Harmvdw/mechanisch-toetsenbord/docs/bronnen.md

# Bronnen

Opgehaald op 10 november 2026. Bron 2 t/m 5 komen uit samenvattingen van de opgehaalde pagina's, niet uit de originele bestanden. Bron 1 en 6 zijn direct in de browser gelezen.

| # | Bron | Status |
|---|---|---|
| 1 | https://github.com/vipul-sharma20/keebs/tree/main | Via de browser gelezen: structuur en kleine delen van de inhoud. Verwerkt in 07. De tool-ophaling werd eerst geweigerd (robots.txt). |
| 2 | https://vipul.xyz/2024/10/lily58-keyboard/ | Opgehaald. Verwerkt in 02, 03, 05. |
| 3 | https://github.com/qmk/qmk_firmware/blob/master/keyboards/lily58/readme.md | Opgehaald (samenvatting). Verwerkt in 01 en 04. |
| 4 | https://github.com/kata0510/Lily58/blob/master/Pro/Doc/buildguide_en.md | Opgehaald (samenvatting). Verwerkt in 02, 03, 05. |
| 5 | https://github.com/kata0510/Lily58 | Opgehaald: alleen mappenstructuur en README. Inhoud van de submappen niet bekeken. Verwerkt in 01. |
| 6 | https://www.printables.com/model/1321348-handwired-lily58 | Via de browser gelezen: beschrijving, onderdelenlijst, bedrading, firmware, licentie. Verwerkt in 08. Tabblad Files niet bekeken. |

## Wat er mist

- Bron 1: `rules.mk` en `keymap.c`, de andere keymaps, licentie van de repo. De STL- en Gerber-bestanden zijn wel gemeten (zie 09).
- Bron 6: tabblad Files, opmerkingen, bedradingsvideo.
- Bestanden in de submappen van bron 5 (`Pro/PCB`, `case`, `pcb`, `Pro_V2`, `Lite_Rev3`).
- De QMK-bestanden naast de readme (`info.json`, `config.h`, `rules.mk`, keymaps).

## Licentie

Aan de repo van kata0510 hangt een `LICENSE`-bestand. Het type is niet gecontroleerd. Neem geen PCB- of casebestanden over zonder de licentie te lezen.
