Harmvdw/mechanisch-toetsenbord/docs/05-lessen-en-problemen.md

# Lessen, fouten en tips

## Uit de Pro-gids (kata0510)

Tips
- Markeer voor- en achterkant van elke print met maskeertape.
- Open de dioden-verpakking langzaam en werk boven een schoteltje: de onderdelen vliegen weg.
- Voorsolderen om onderdelen vast te zetten.
- Defecte switch: verwijderen, pinnen op kromming controleren, opnieuw plaatsen.

Waarschuwingen
- Zwarte versie: krasvaste coating (soldeermasker), maar krassen door transport zijn mogelijk. Na montage krast de case snel.
- Verkeerd geplaatste diode: de toets reageert niet.
- De Pro Micro-socket is kwetsbaar. Magnetische micro-USB-connector aanbevolen.
- Kailh Box- en Choc-switches vragen kracht bij het plaatsen.
- Sockets niet met de hand vasthouden tijdens het solderen.

Storingen
- Rij of kolom reageert niet: Pro Micro niet goed gesoldeerd. Opnieuw solderen en monteren.
- Eén toets reageert niet: switchmontage, socket en diode-soldeerverbinding controleren, diode-oriëntatie corrigeren.

## Uit de blog (vipul.xyz)

| Probleem | Oplossing of les |
|---|---|
| Diodes verkeerd geplaatst | Omkeren, opnieuw solderen |
| Losse verbindingen bij diodes en sockets | Opnieuw solderen |
| Pin headers Pro Micro maakten geen contact | Elke pin afzonderlijk nasolderen |
| Hardnekkige toetsen | Socket, diode en switch vervangen (loste 1–2 toetsen op) |
| Print beschadigd bij het verwijderen van pin headers (koperbanen los) | Uitwijken naar een ander bord |
| Beide helften als rechterhelft gesoldeerd | Alles ontsolderen. Helften zijn spiegelbeeldig. |
| Na eerste flash werkten ca. 10 toetsen niet | Soldeerfouten zoeken en herstellen |

Tips van de auteur
- Flash de firmware vóór de keycaps.
- Gebruik een multimeter om fouten te zoeken.
- Controleer of pin headers helemaal door de print gaan vóór het solderen.
- Plan bouw en logistiek goed (onderdelen uit het buitenland: douane en ontbrekende delen).
- Groen soldeermasker is goedkoper dan zwart.
