Harmvdw/mechanisch-toetsenbord/behuizing/afbeeldingen/fusion_helft_rechts.png

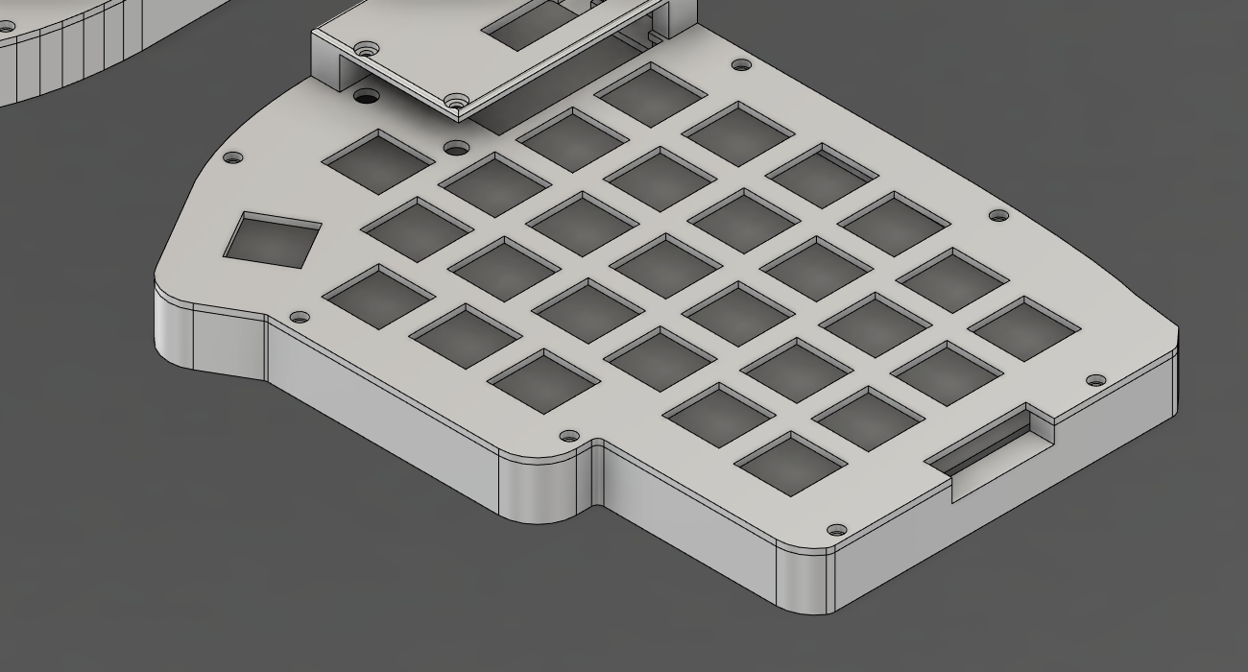
behuizing/afbeeldingen/fusion_helft_rechts.png
