Harmvdw/mechanisch-toetsenbord/behuizing/afbeeldingen/helft_3d.png

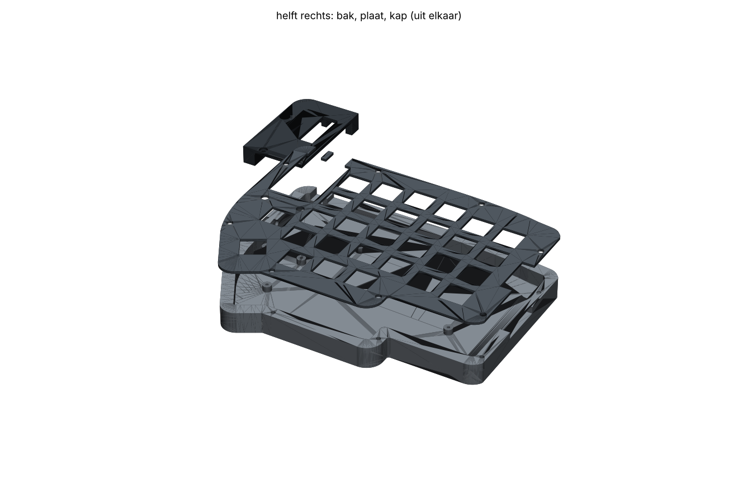
behuizing/afbeeldingen/helft_3d.png
