Harmvdw/mechanisch-toetsenbord/behuizing/afbeeldingen/helft_3d_gemonteerd.png

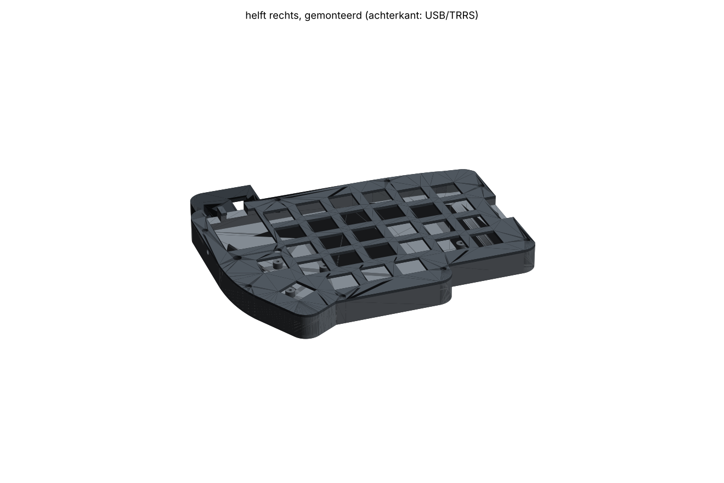
behuizing/afbeeldingen/helft_3d_gemonteerd.png
