Harmvdw/mechanisch-toetsenbord/behuizing/afbeeldingen/helft_doorsnede.png

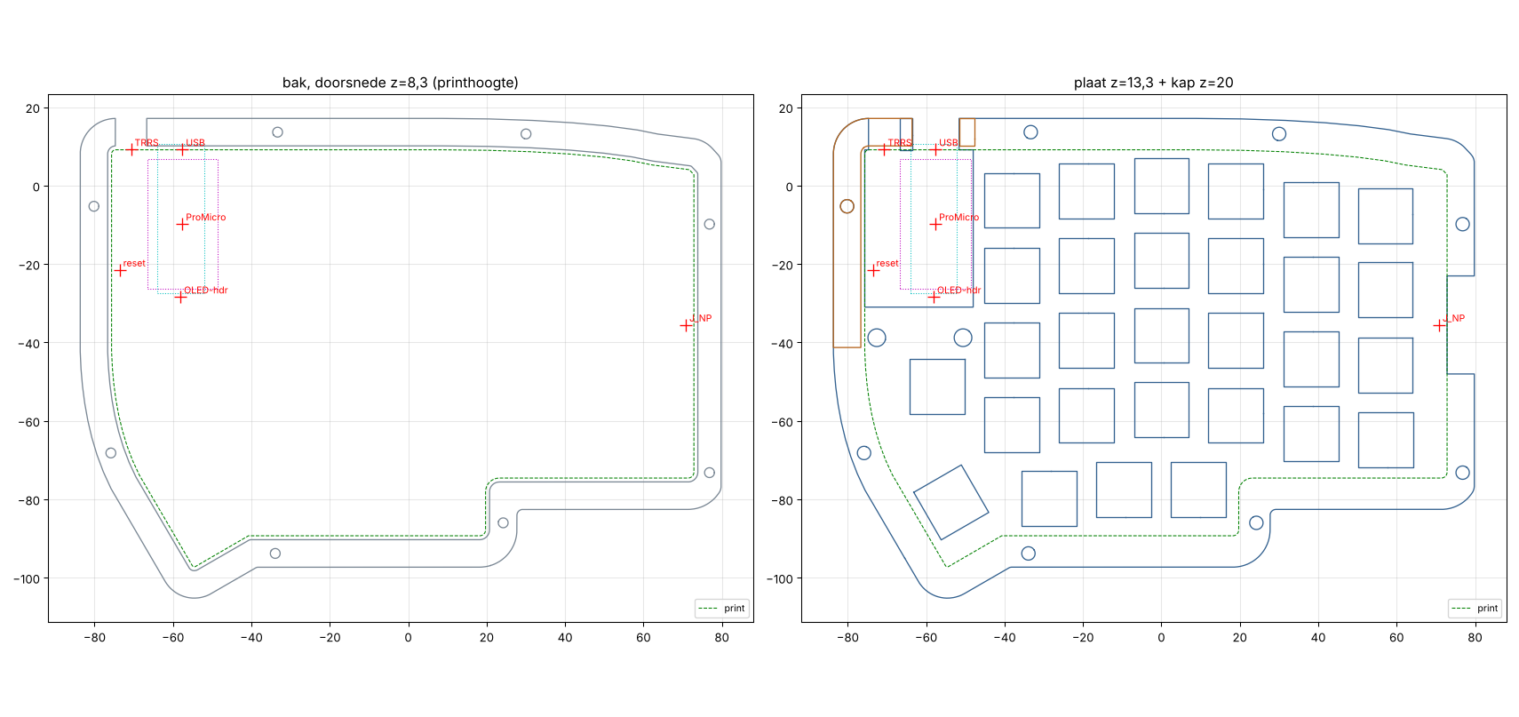
behuizing/afbeeldingen/helft_doorsnede.png
