Harmvdw/mechanisch-toetsenbord/behuizing/afbeeldingen/numpad_3d.png

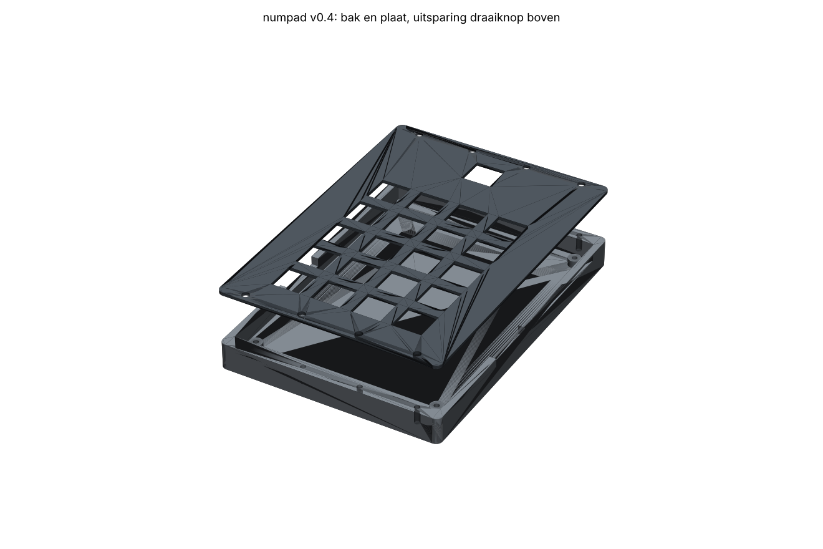
behuizing/afbeeldingen/numpad_3d.png
