Harmvdw/mechanisch-toetsenbord/behuizing/afbeeldingen/numpad_doorsnede.png

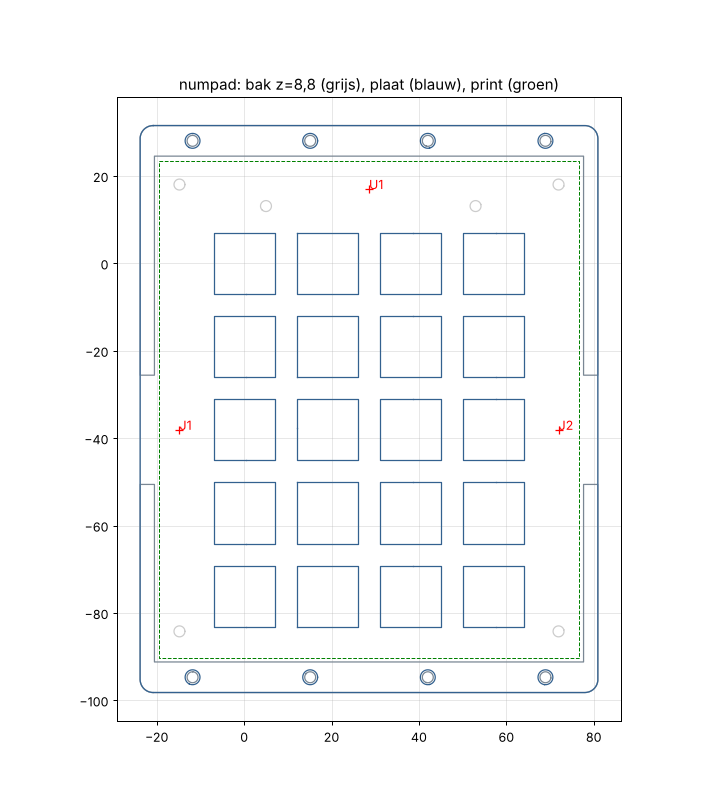
behuizing/afbeeldingen/numpad_doorsnede.png
