Harmvdw/mechanisch-toetsenbord/behuizing/export/numpad_bak.step

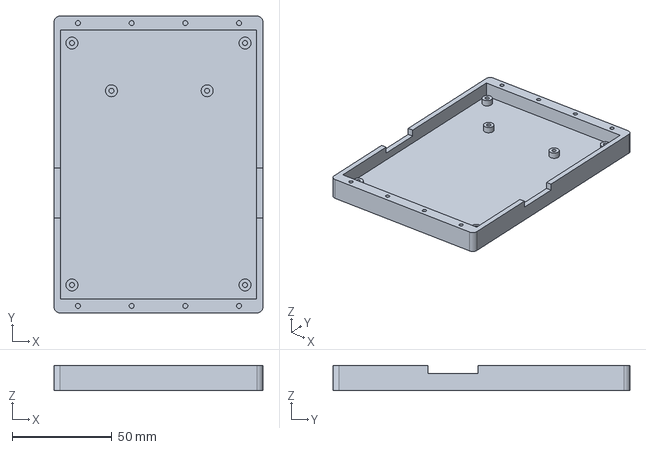
[picture p9: CAD file, 2026-11-13]
behuizing/export/numpad_bak.step
104.8 x 148.8 x 12.6 mm
