Harmvdw/mechanisch-toetsenbord/behuizing/export/numpad_plaat.step

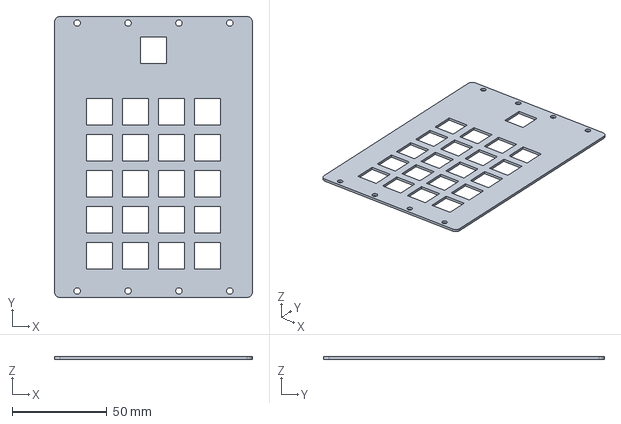
[picture p10: CAD file, 2026-11-13]
behuizing/export/numpad_plaat.step
104.8 x 148.8 x 1.50 mm
