Harmvdw/mechanisch-toetsenbord/behuizing/export/helft_rechts_kap.step

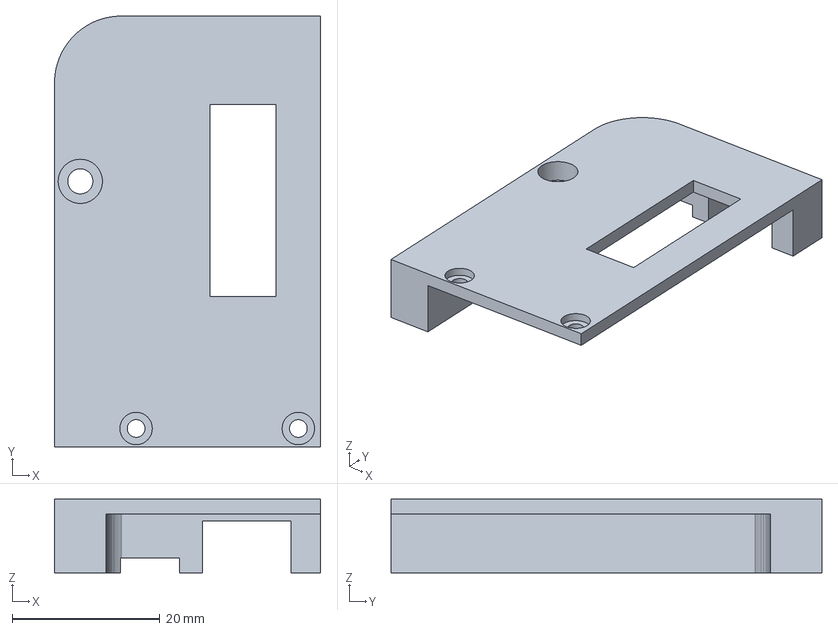
[picture p11: CAD file, 2026-11-12]
behuizing/export/helft_rechts_kap.step
36.1 x 58.4 x 10.0 mm
