Harmvdw/mechanisch-toetsenbord/behuizing/export/helft_rechts_bak.step

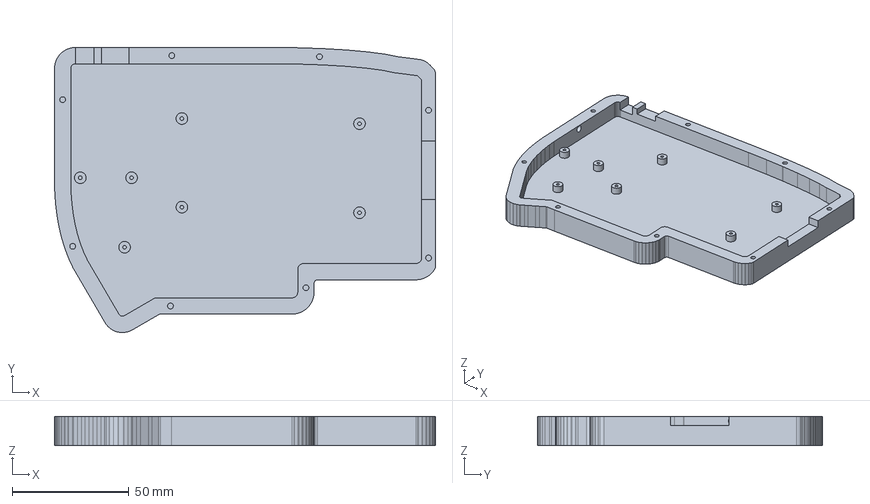
[picture p12: CAD file, 2026-11-12]
behuizing/export/helft_rechts_bak.step
163.5 x 122.3 x 12.6 mm
