Harmvdw/mechanisch-toetsenbord/behuizing/export/helft_rechts_plaat.step

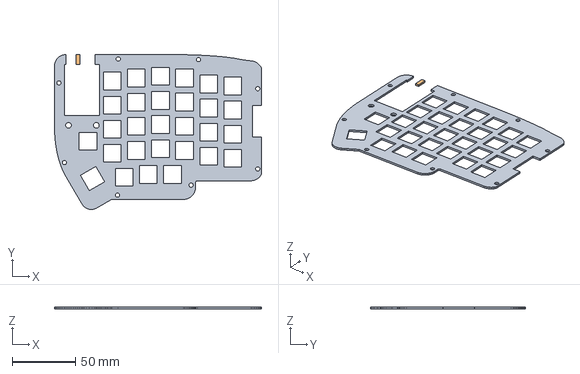
[picture p13: CAD file, 2026-11-12]
behuizing/export/helft_rechts_plaat.step
163.5 x 122.3 x 1.50 mm
