Harmvdw/mechanisch-toetsenbord/(list of files, cad)

Other CAD files:
behuizing/export/helft_rechts_bak.stl
behuizing/export/helft_rechts_kap.stl
behuizing/export/helft_rechts_plaat.stl
behuizing/export/numpad_bak.stl
behuizing/export/numpad_plaat.stl
