Harmvdw/mechanisch-toetsenbord/pcb/numpad/numpad.kicad_pcb

## KiCad design pcb/numpad/numpad.kicad_pcb (2026-11-13)

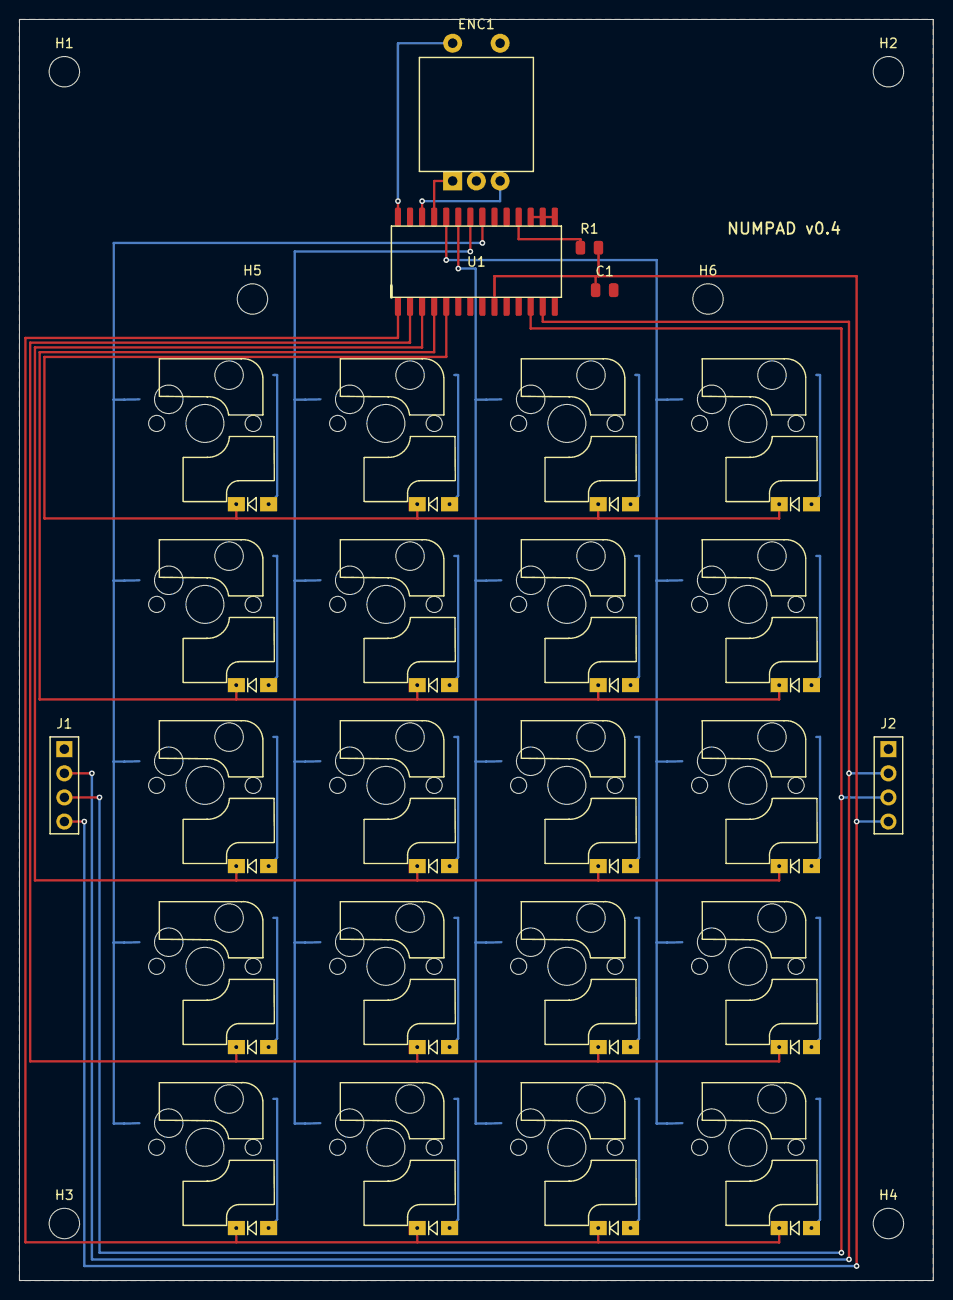
[picture p14: board numpad.kicad_pcb from above]

Board: 2 copper layers, 96.2 x 132.8 mm, 52 parts (0 on the bottom side), 37 nets.

Parts:
C1: 100nF; C_0805
D1, D2, D3, D4, D5, D6, D7, D8, D9, D10, D11, D12, D13, D14, D15, D16, D17, D18, D19, D20: 1N4148W; Diode_SOD123
ENC1: EC11 met drukknop; RotaryEncoder_EC11E_Switch
H1, H2, H3, H4, H5, H6: M3; MountingHole_3.2mm
J1, J2: Adafruit 5358; Magnetic_5358_1x4_P2.54_Vertical
R1: 10k; R_0805
SW1, SW2, SW3, SW4, SW5, SW6, SW7, SW8, SW9, SW10, SW11, SW12, SW13, SW14, SW15, SW16, SW17, SW18, SW19, SW20: MX_hotswap; CherryMX_KailhLowProfile_Hotswap_edge
U1: MCP23017-E/SO; SOIC-28W_7.5x17.9mm_P1.27mm

Connections:
GND: C1.2, ENC1.C, ENC1.S2, J1.1, J2.1, U1.10, U1.15, U1.16, U1.17
unnamed: D1.2, SW1.2
unnamed: D2.2, SW2.2
unnamed: D3.2, SW3.2
unnamed: D4.2, SW4.2
unnamed: D5.2, SW5.2
unnamed: D6.2, SW6.2
unnamed: D7.2, SW7.2
unnamed: D8.2, SW8.2
unnamed: D9.2, SW9.2
unnamed: D10.2, SW10.2
unnamed: D11.2, SW11.2
unnamed: D12.2, SW12.2
unnamed: D13.2, SW13.2
unnamed: D14.2, SW14.2
unnamed: D15.2, SW15.2
unnamed: D16.2, SW16.2
unnamed: D17.2, SW17.2
unnamed: D18.2, SW18.2
unnamed: D19.2, SW19.2
unnamed: D20.2, SW20.2
SCL: J1.3, J2.3, U1.12
SDA: J1.2, J2.2, U1.13
VCC: C1.1, J1.4, J2.4, R1.2, U1.9
nRESET: R1.1, U1.18
np_col0: SW1.1, SW5.1, SW9.1, SW13.1, SW17.1, U1.21
np_col1: SW2.1, SW6.1, SW10.1, SW14.1, SW18.1, U1.22
np_col2: SW3.1, SW7.1, SW11.1, SW15.1, SW19.1, U1.23
np_col3: SW4.1, SW8.1, SW12.1, SW16.1, SW20.1, U1.24
np_encA: ENC1.A, U1.25
np_encB: ENC1.B, U1.26
np_encS: ENC1.S1, U1.28
np_row0: D1.1, D2.1, D3.1, D4.1, U1.5
np_row1: D5.1, D6.1, D7.1, D8.1, U1.4
np_row2: D9.1, D10.1, D11.1, D12.1, U1.3
np_row3: D13.1, D14.1, D15.1, D16.1, U1.2
np_row4: D17.1, D18.1, D19.1, D20.1, U1.1
