Harmvdw/mechanisch-toetsenbord/(commit log)

2026-11-10 Voeg keebs-repo en Printables-model toe, werk bronnenlijst bij
    Claude-Session: https://claude.ai/code/session_01JpGuJ3zyjAJrwZ9p57ohZi
2026-11-10 Voeg gemeten maten uit STL's en Gerber-bestanden toe
    Toetsposities (CSV), stagger, printrand, plaat- en casematen en de
    meetscripts. Werk bronnenlijst en 06/07 bij.
    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
    [lily58-pro-switchposities.csv]
2026-11-10 Voeg Fusion-opzet toe en werk hoekmeting van duimtoetsen bij
    De toets op (105,0; -127,0) is 30 graden gedraaid, de rest recht.
    Beschrijf schetsen en parameters in docs/10.
    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
2026-11-10 Voeg PCB-route, printrand en bestelplan toe
    Edge_Cuts van de Pro-print als punten (CSV) en als Fusion-schets,
    bevindingen over KiCad-import in Fusion en plan voor de bestelling.
    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
    [lily58-pro-printrand.csv]
2026-11-12 Behuizing prototype v0.1 (rechterhelft + numpad), PCB-scripts en documentatie
    - behuizing/behuizing.py: parametrisch CadQuery-model (bak, plaat, kap), STEP/STL-exports
    - controle-afbeeldingen (doorsneden met printrand en componenten)
    - pcb/scripts: numpad-generator, Lily58-aanpassing en router (route 2)
    - docs/12 (numpad en print), docs/13 (behuizing), eisen-en-wensen v6, README
    Claude-Session: https://claude.ai/code/session_01JpGuJ5Gf5HgQMCScptgPZn
    [helft_rechts_bak.step, helft_rechts_bak.stl, helft_rechts_kap.step, helft_rechts_kap.stl, helft_rechts_plaat.step, helft_rechts_plaat.stl, numpad_bak.step, numpad_bak.stl]
2026-11-12 Behuizing Fusion v0.3: resetsleuf, een opening USB/TRRS, M2-verzinking in de kap
    Claude-Session: https://claude.ai/code/session_01JpGuJ4RkEzEevFCpUaoQmt
2026-11-12 Tekst: plek KiCad-bestanden
    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
2026-11-13 KiCad-bestanden, DRC-rapporten en Gerbers naar pcb/
    - pcb/lily58-pro: aangepaste print (route 2), footprintbibliotheek, DRC, Gerbers
    - pcb/lily58-pro/origineel: uitgangspunt kata0510 (schema, netlijst, bord)
    - pcb/numpad: numpad-print, DRC, Gerbers
    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
    [Lily58_Pro.kicad_pcb, Lily58_Pro.sch, Lily58_Pro_origineel.kicad_pcb, numpad.kicad_pcb]
2026-11-13 Draaiknop (EC11) op SW25 als combinatie met gesoldeerde MX-switch
    - SW25: hotswap past niet samen met een encoder op de omkeerbare print;
    nu 4 doorgemetalliseerde gaten voor een gesoldeerde MX-switch
    - ENC1 op hetzelfde middelpunt: A->F4, B->F5, C->GND, drukknop op matrixplek SW25
    - opnieuw gerouteerd (col5, D25, F4, F5), DRC: 0 niet-verbonden, geen nieuwe fouten
    - nieuwe Gerbers (13 nov); script pcb/scripts/encoder_lily58.py
    - docs 12, 14 en eisen bijgewerkt
    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
    [Lily58_Pro.kicad_pcb]
2026-11-13 Numpad v0.4: draaiknop EC11 in verlengde bovenstrook (MCP23017 GPA4/GPA5/GPA7), behuizing mee verlengd
    - gen_numpad.py: parameter ENC (19 mm), ENC1-footprint, nets en routering; bestaande layout ongewijzigd
    - numpad.kicad_pcb opnieuw gegenereerd; DRC en Gerbers nog te doen in KiCad
    - oude Gerbers hernoemd naar numpad_gerbers_v0.3_ZONDER_draaiknop.zip
    - afstand_controle.py: snelle afstandscontrole zonder KiCad
    - behuizing.py: numpad 148,8 mm lang, plaatuitsparing voor de knop; exports en afbeelding bijgewerkt
    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
    [numpad.kicad_pcb, numpad_bak.step, numpad_bak.stl, numpad_plaat.step, numpad_plaat.stl]
